zknb-666/Quadruped_robot/单片机控制代码/Quadruped_Robot/Src/main.c

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

/* Includes ------------------------------------------------------------------*/
#include "main.h"
#include "cmsis_os.h"
#include "tim.h"
#include "usart.h"
#include "gpio.h"

/* USER CODE BEGIN Includes */
#include "stdio.h"
#include <string.h>
#include "Ultrasonic.h"  // 添加超声波模块头文件
#include "Debug_Output.h" // 添加调试输出重定向
/* USER CODE END Includes */


/* USER CODE BEGIN PV */
extern osMailQId myMail01Handle;	
uint8_t data[20];
extern osMailQId myMail02Handle;	
uint8_t data2[20];
//extern osMailQId myMail03Handle;	
//uint8_t data3[20];
/*******USART3陀螺仪数据接收变量*******/
uint8_t Re_buf[11],counter=0;
unsigned char sign=0;  // 添加sign变量定义
static unsigned char Temp[11];

/*******UART4超声波模块数据接收变量*******/
uint8_t Re_buf2[10],counter2=0;
static unsigned char Temp2[10];
uint8_t data3[10];

/* USER CODE END PV */

void SystemClock_Config(void);
void MX_FREERTOS_Init(void);
/* USER CODE BEGIN 0 */

// fputc重定向已移至Debug_Output.c模块

/* USER CODE END 0 */

/**
  * @brief  The application entry point.
  * @retval int
  */
int main(void)
{
  /* MCU Configuration--------------------------------------------------------*/

  /* Reset of all peripherals, Initializes the Flash interface and the Systick. */
  HAL_Init();

  /* Configure the system clock */
  SystemClock_Config();

  /* Initialize all configured peripherals */
  MX_GPIO_Init();
  MX_USART1_UART_Init();
  MX_USART2_UART_Init();
  MX_TIM1_Init();
  MX_TIM2_Init();
  MX_TIM3_Init();
  MX_TIM4_Init();
  MX_USART3_UART_Init();
  MX_UART4_Init();
  /* USER CODE BEGIN 2 */
  
  printf("** System inited successfully. ** \r\n");  // 此时调试系统已经初始化，会输出到蓝牙

  /* USER CODE END 2 */  /* Call init function for freertos objects (in freertos.c) */
  MX_FREERTOS_Init(); 
  /* Start scheduler */
  osKernelStart();
 
  /* We should never get here as control is now taken by the scheduler */
  /* Infinite loop */
  /* USER CODE BEGIN WHILE */
  while (1)
  {
    /* USER CODE END WHILE */

    /* USER CODE BEGIN 3 */
  }
  /* USER CODE END 3 */
}

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
/* USER CODE BEGIN 4 */

// fputc重定向实现已移至Debug_Output.c模块

void HAL_UART_RxCpltCallback(UART_HandleTypeDef *huart)
{
	if(huart->Instance == USART2)
	{
		osMailPut(myMail01Handle,data);
		HAL_UART_Receive_IT(&huart2,data,2);
	}
	
	if(huart->Instance == USART3)
	{
		Temp[counter]=data2[0];
		if(counter == 0 && Temp[0] != 0x55)
		{		
			HAL_UART_Receive_IT(&huart3,data2,1);
			return; //第0个数据不是帧头，丢弃   
		}			
    counter++; 
		//printf("%d \n",counter);
    if(counter==11) //接收到11个数据
    { 
			memcpy(Re_buf,Temp,11);   //将Temp数组复制到Re_buf
      counter=0;                //重新赋值，准备下一帧数据的接收
			sign=1;                   // 设置数据准备标志
			osMailPut(myMail02Handle,Re_buf);
    }
		HAL_UART_Receive_IT(&huart3,data2,1);
	}
	
	if(huart->Instance == UART4)
	{
		Temp2[counter2]=data3[0];
		if(counter2 == 0 && Temp2[0] != 68) 
		{		
			HAL_UART_Receive_IT(&huart4,data3,1);
			return; //第0个数据不是帧头，丢弃   
		}			
    counter2++; 
    if(counter2==5) //接收到5个数据
    { 
			memcpy(Re_buf2,Temp2,5);   //将Temp数组复制到Re_buf
      counter2=0;                //重新赋值，准备下一帧数据的接收
			
			// 处理超声波数据
			Ultrasonic_ProcessData(Re_buf2, 5);
    }
		HAL_UART_Receive_IT(&huart4,data3,1);
	}	
}

/* USER CODE END 4 */

 /**
  * @brief  Period elapsed callback in non blocking mode
  * @note   This function is called  when TIM8 interrupt took place, inside
  * HAL_TIM_IRQHandler(). It makes a direct call to HAL_IncTick() to increment
  * a global variable "uwTick" used as application time base.
  * @param  htim : TIM handle
  * @retval None
  */
void HAL_TIM_PeriodElapsedCallback(TIM_HandleTypeDef *htim)
{
  if (htim->Instance == TIM8) {
    HAL_IncTick();
  }
}

/**
  * @brief  This function is executed in case of error occurrence.
  * @retval None
  */
void Error_Handler(void)
{
  /* USER CODE BEGIN Error_Handler_Debug */
  /* User can add his own implementation to report the HAL error return state */

  /* USER CODE END Error_Handler_Debug */
}

#ifdef  USE_FULL_ASSERT
/**
  * @brief  Reports the name of the source file and the source line number
  *         where the assert_param error has occurred.
  * @param  file: pointer to the source file name
  * @param  line: assert_param error line source number
  * @retval None
  */
void assert_failed(uint8_t *file, uint32_t line)
{ 
  /* USER CODE BEGIN 6 */
  /* User can add his own implementation to report the file name and line number,
     tex: printf("Wrong parameters value: file %s on line %d\r\n", file, line) */
  /* USER CODE END 6 */
}
#endif /* USE_FULL_ASSERT */

/************************ (C) COPYRIGHT STMicroelectronics *****END OF FILE****/
