zknb-666/Quadruped_robot/单片机控制代码/Quadruped_Robot/App/Src/MPU6050.c

#include "Inverse_K.h"  // 直接包含确保类型定义可见
#include "MPU6050.h"
#include "string.h"
#include "math.h"
#include "Debug_Output.h"  // 添加调试输出重定向


/*******USART3陀螺仪数据接收变量*******/
extern unsigned char Re_buf[11];
extern unsigned char sign;
float a[3]={0},w[3]={0},angle[3]={0};
//float T;

float acc_offset[3]={0};
float gyro_offset[3]={0};
int Gyro_calibration_times=0;
int Gyro_calibration_times2=0;

float q0 = 1, q1 = 0, q2 = 0, q3 = 0;    // quaternion elements representing the estimated orientation  四元数
float exInt = 0, eyInt = 0, ezInt = 0;    // scaled integral error  
floatRPY Q_ANGLE;  // 修正结构体声明

// 外部函数声明放到函数外部
void LegAngle_to_ServoPos(floatXYZ pos, floatRPY angle);

/*****陀螺仪数据解析函数******/
void Gyroscopetest(void)
{
	
   unsigned char Temp[11];
   if(sign)
   {  
      memcpy(Temp,Re_buf,11);
      sign=0;
      if(Re_buf[0]==0x55)       //检查帧头
      {  	
				switch(Re_buf[1])
            {
               case 0x51: //加速度包
                  a[0] = ((short)(Temp[3]<<8 | Temp[2]))/32768.0*16*9.8;      //X轴加速度
                  a[1] = ((short)(Temp[5]<<8 | Temp[4]))/32768.0*16*9.8;      //Y轴加速度
                  a[2] = ((short)(Temp[7]<<8 | Temp[6]))/32768.0*16*9.8;      //Z轴加速度
							 /***
									if(Gyro_calibration_times<50)
							    {
										 acc_offset[0]+=a[0];
										 acc_offset[1]+=a[1];
										 acc_offset[2]+=a[2];
										 Gyro_calibration_times++;
									}
									else
									{	
										 a[0]=a[0]-acc_offset[0]/50;
										 a[1]=a[1]-acc_offset[1]/50;
										 a[2]=9.8+a[2]-acc_offset[2]/50;	
									}		
							 ***/
									// T    = ((short)(Temp[9]<<8 | Temp[8]))/340.0+36.25;      //温度
                  break;
               case 0x52: //角速度包
                  w[0] = ((short)(Temp[3]<<8| Temp[2]))/32768.0*2000;      //X轴角速度
                  w[1] = ((short)(Temp[5]<<8| Temp[4]))/32768.0*2000;      //Y轴角速度
                  w[2] = ((short)(Temp[7]<<8| Temp[6]))/32768.0*2000;      //Z轴角速度
							 /****
							 		if(Gyro_calibration_times2<50)
									{
										gyro_offset[0]+=w[0];
										gyro_offset[1]+=w[1];
										gyro_offset[2]+=w[2];
										Gyro_calibration_times2++;
									}
									else
									{	
										w[0]=w[0]-gyro_offset[0]/50;
										w[1]=w[1]-gyro_offset[1]/50;
										w[2]=w[2]-gyro_offset[2]/50;	
									}
							 ****/
                 // T    = ((short)(Temp[9]<<8| Temp[8]))/340.0+36.25;      //温度
                  break;
               case 0x53: //角度包
                  angle[0] = ((short)(Temp[3]<<8| Temp[2]))/32768.0*180;   //X轴滚转角
                  angle[1] = ((short)(Temp[5]<<8| Temp[4]))/32768.0*180;   //Y轴俯仰角
                  angle[2] = ((short)(Temp[7]<<8| Temp[6]))/32768.0*180;   //Z轴偏航角
	
                 // T        = ((short)(Temp[9]<<8| Temp[8]))/340.0+36.25;   //温度
                  break;
               default:  break;
            }
						//if(Gyro_calibration_times<50||Gyro_calibration_times2<50)
						//	printf("Gyro_calibration_times=%d\r\n",Gyro_calibration_times);
						//else
							DEBUG_DEBUG("X加速度:%.2f  Y加速度:%.2f  Z加速度:%.2f X角速度:%.2f  Y角速度:%.2f  Z角速度:%.2f   X角度:%.2f  Y角度:%.2f  Z角度:%.2f\r\n",
						 				a[0],a[1],a[2],w[0],w[1],w[2],angle[0],angle[1],angle[2]);
																//四元数解算
      }  			
   } 

  
}

/*******陀螺仪数据处理函数******/
void IMUupdate(float gx, float gy, float gz, float ax, float ay, float az)
{
  float norm;
  //float hx, hy, hz, bx, bz;
  float vx, vy, vz;// wx, wy, wz;
  float ex, ey, ez;
 
  float q0q0 = q0*q0;
  float q0q1 = q0*q1;
  float q0q2 = q0*q2;
  //float q0q3 = q0*q3;
  float q1q1 = q1*q1;
  //float q1q2 = q1*q2;
  float q1q3 = q1*q3;
  float q2q2 = q2*q2;
  float q2q3 = q2*q3;
  float q3q3 = q3*q3;
 
  norm = sqrt(ax*ax + ay*ay + az*az);       //acc数据归一化
	if(norm==0)  return;
  ax = ax /norm;
  ay = ay / norm;
  az = az / norm;
 
  // estimated direction of gravity and flux (v and w)              重力加速度和地磁场方向/数值
  vx = 2*(q1q3 - q0q2);                                             //四元数与xyz的表示
  vy = 2*(q0q1 + q2q3);
  vz = q0q0 - q1q1 - q2q2 + q3q3 ;
 
  // error is sum of cross product between reference direction of fields and direction measured by sensors
  ex = (ay*vz - az*vy) ;                                             //用外积误差来修正陀螺仪的漂移误差
  ey = (az*vx - ax*vz) ;
  ez = (ax*vy - ay*vx) ;
 
  exInt = exInt + ex * Ki * 2 * halfT;                                //误差积分
  eyInt = eyInt + ey * Ki * 2 * halfT;
  ezInt = ezInt + ez * Ki * 2 * halfT;
 
  // adjusted gyroscope measurements
  gx = gx + Kp*ex + exInt;                                              //通过PI补偿陀螺仪角速度，消除陀螺仪漂移
  gy = gy + Kp*ey + eyInt;
  gz = gz + Kp*ez + ezInt;                                          //这里gz没有观测矢量进行融合校正，可能出现累计误差，需要人工零偏校正
 
  // integrate quaternion rate and normalise                           //四元数微分方程
  q0 = q0 + (-q1*gx - q2*gy - q3*gz)*halfT;
  q1 = q1 + (q0*gx + q2*gz - q3*gy)*halfT;
  q2 = q2 + (q0*gy - q1*gz + q3*gx)*halfT;
  q3 = q3 + (q0*gz + q1*gy - q2*gx)*halfT;
	

 
  // normalise quaternion
  norm = sqrt(q0*q0 + q1*q1 + q2*q2 + q3*q3);
  q0 = q0 / norm;
  q1 = q1 / norm;
  q2 = q2 / norm;
  q3 = q3 / norm;
 
  //Q_ANGLE.Y = atan2(2 * q1 * q2 + 2 * q0 * q3,q0*q0+q1*q1-q2*q2-q3*q3)* 57.3; // yaw
  Q_ANGLE.Y = atan2(2 * q1 * q2 + 2 * q0 * q3, -2 * q2*q2 - 2 * q3* q3 + 1); // yaw
  Q_ANGLE.P = asin(-2 * q1 * q3 + 2 * q0* q2); // pitch
  Q_ANGLE.R = atan2(2 * q2 * q3 + 2 * q0 * q1, -2 * q1 * q1 - 2 * q2* q2 + 1); // roll
}

/*****四元数解算函数*****/
floatRPY MUP6050_Data_Process(void)  // 修正返回类型
{
	Gyroscopetest();
	//IMUupdate(w[0],w[1],w[2],a[0],a[1],a[2]);
	//if(Gyro_calibration_times>=50&&Gyro_calibration_times2>=50)
	//	printf("P=%.2f,R=%.2f,Y=%.2f\r\n \r\n",Q_ANGLE.P,Q_ANGLE.R,Q_ANGLE.Y);
	return Q_ANGLE;
}

void IMU_Attitude_Control(void)
{
	float KP=-1;
	floatRPY euler_angle;  // 修正结构体类型
	floatXYZ pos;         // 修正结构体类型
	pos.x=0;
	pos.y=0;
	pos.z=150;
	euler_angle=MUP6050_Data_Process();
	
	//euler_angle.P=KP*euler_angle.P;
	//euler_angle.R=KP*euler_angle.R;
	//euler_angle.Y=KP*euler_angle.Y;
	euler_angle.P=KP*angle[1];
	euler_angle.R=KP*angle[0];
	euler_angle.Y=KP*angle[2];
	LegAngle_to_ServoPos(pos,euler_angle);  
	//delay_ms(20);
}
