zknb-666/Quadruped_robot/单片机控制代码/Quadruped_Robot/Task/Inc/sysconfig.h

/*头文件预声明*/
#ifndef __SYSCONFIG_H__
#define __SYSCONFIG_H__

/*包含头文件*/
/*c头文件*/
#include <stdlib.h>
#include <math.h>
#include <string.h> 

/*BSP*/
#include "main.h"
#include "stm32f1xx_hal.h"
/*OS*/
#include "cmsis_os.h"
/*自定义头文件*/

#endif
