zknb-666/Quadruped_robot/(commit log)

2025-08-23 添加 .gitignore 文件以忽略构建输出和临时文件
2025-08-23 Refactor and enhance Quadruped Robot firmware
    - Removed obsolete task_led1 and task_led2 files, including their object and dependency files.
    - Updated task_servocontrol and task_statemachine to include new dependencies for debugging and ultrasonic processing.
    - Added debugging output functionality across various tasks, improving traceability and monitoring.
    - Enhanced main.c to integrate ultrasonic data processing and debugging output.
    - Refactored Task_IMU and Task_Init to include debugging initialization and ultrasonic module integration.
    - Updated ServoControl task to support new servo position calculations based on IMU data.
    - General code cleanup and organization for better maintainabil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
2025-08-23 Add hardware configuration and data sending modules for quadruped robot
    - Created Hardware_Config.h and Hardware_Config.c to manage hardware wiring configurations and I2C communication for MPU6050 and ultrasonic sensors.
    - Implemented Data_Sender.c to handle JSON data transmission for IMU and ultrasonic sensor readings.
    - Updated FreeRTOS configuration to include a new data sending task with appropriate stack sizes and priorities.
    - Enhanced Task_Init to initialize hardware configurations and test sensor functionality, ensuring proper setup before starting the data sending task.
    - Adjusted FreeRTOSConfig.h to increase heap size for dynamic memory allocation.
    - Updated project files to includ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
2025-08-23 Update .gitignore with comprehensive STM32/Keil project rules
2025-08-23 Add PowerShell Git helper script for STM32 project management
2025-08-23 添加步态模式和主状态字符串获取功能，更新数据发送模块以包含机器人模式信息，并新增指令说明文档
2025-08-23 添加简化JSON格式字段映射和数据发送功能，优化数据包大小，提高传输效率
2025-08-24 删除冗余的IMU、LED和舵机控制头文件，以简化项目结构
2025-08-24 删除未使用的步态模式和主状态字符串获取函数，简化数据发送模块
2025-08-24 添加机器人接线说明，明确各舵机连接引脚
2025-08-24 修正机器人身体和脚部尺寸定义，确保与实际硬件一致
2025-08-24 修正侧移步长和抬足高度的定义，确保与实际运动需求一致
