zknb-666/Quadruped_robot/(notices)

Notices in the files:
单片机控制代码/Quadruped_Robot/Src/main.c:
© Copyright (c) 2020 STMicroelectronics.
All rights reserved.
This software component is licensed by ST under Ultimate Liberty license
